RastoH/eXtended-Coop-Controller/webUI/readme.md

# 1. Main page
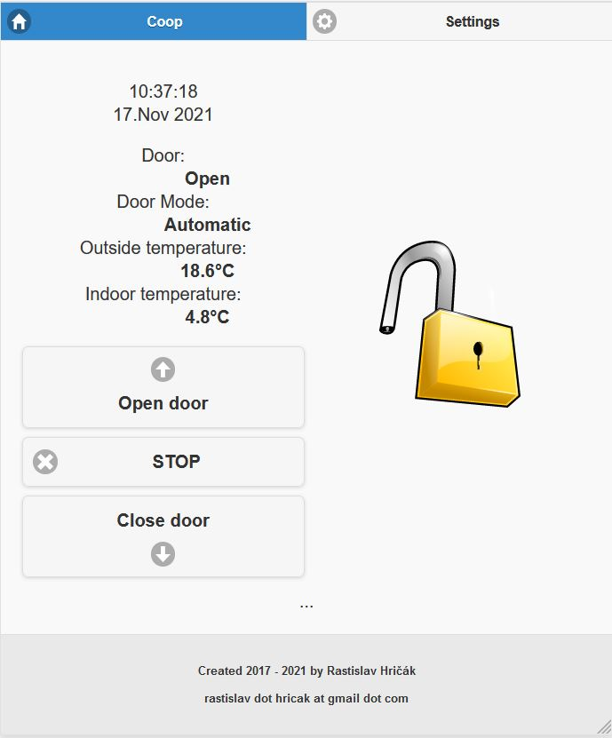
[picture p3: webUI/main1.JPG]

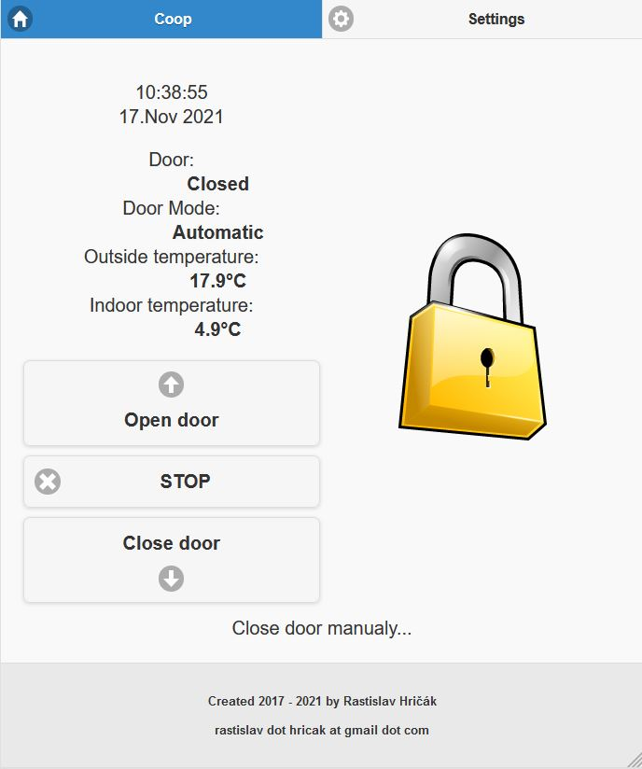
[picture p4: webUI/main2.JPG]

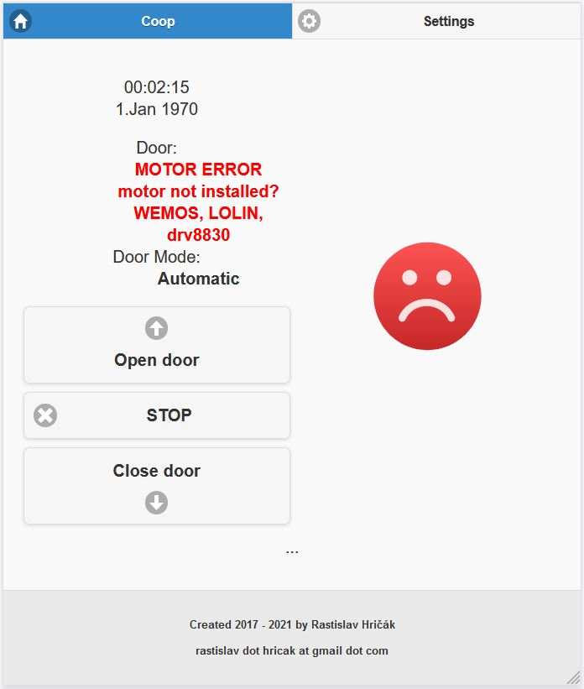
[picture p5: webUI/main_without.JPG]


# 2. Settings page
## 2.1 Door settings

#### 2.1.1 Door modes 

#### 2.1.1.1 Manual

#### 2.1.1.2 Light 

#### 2.1.1.3 Time

#### 2.1.1.4 Automatic mode
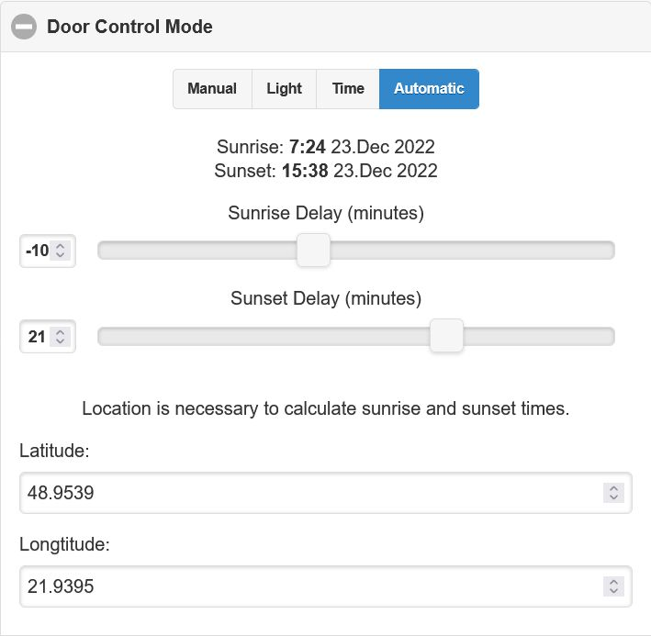
[picture p6: webUI/door_mode_automatic.jpg]

The location of interest, in decimal degrees.    

***Latitude*** is a coordinate that specifies the north–south position of a point on the surface of the Earth or another celestial body.
> Latitude ranges	from -90 (south pole) to 90 (north pole).

***Longitude*** is a geographic coordinate that specifies the east–west position of a point on the surface of the Earth, or another celestial body.
 > Longitude ranges	from -180 (west of Greenwich) to 180 (east of Greenwich).
  
### 2.1.2 Freeze protect

### 2.1.3 Quarantine

## 2.2 Accessory settings
#### 2.2.1.1 Hen light 
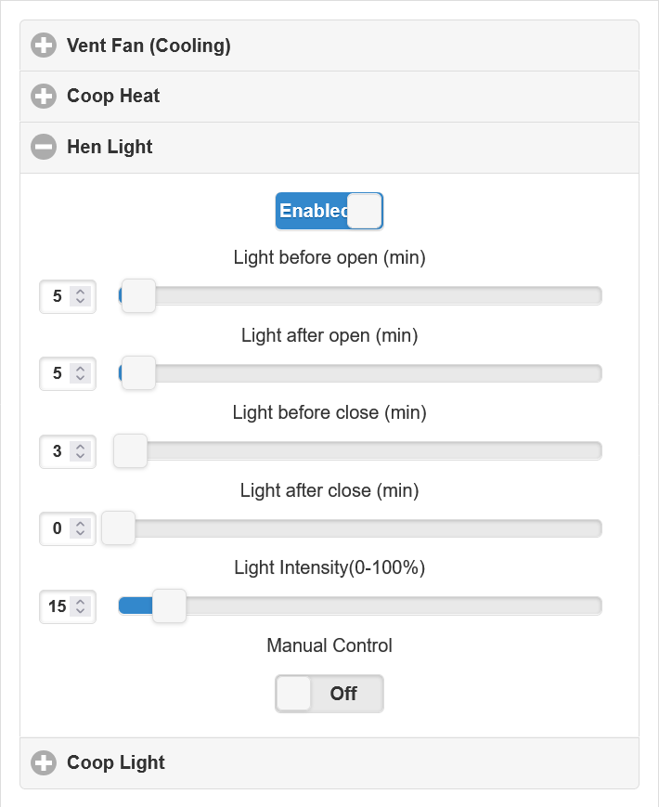
[picture p7: webUI/hen_light.png]

#### 2.2.1.2 Coop light 
#### 2.2.1.3 Vent Fan (Cooling)
#### 2.2.1.4 Heater
### 2.2.2 Water heater 
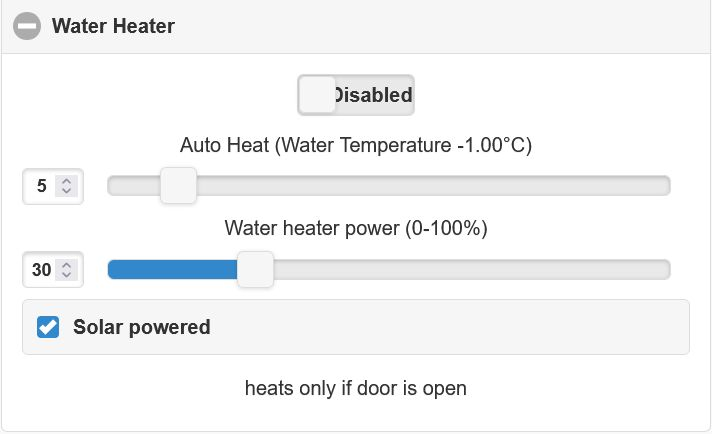
[picture p8: webUI/water_heater.jpg]

## 2.3 System config

### 2.3.1 Door name
### 2.3.2 Security
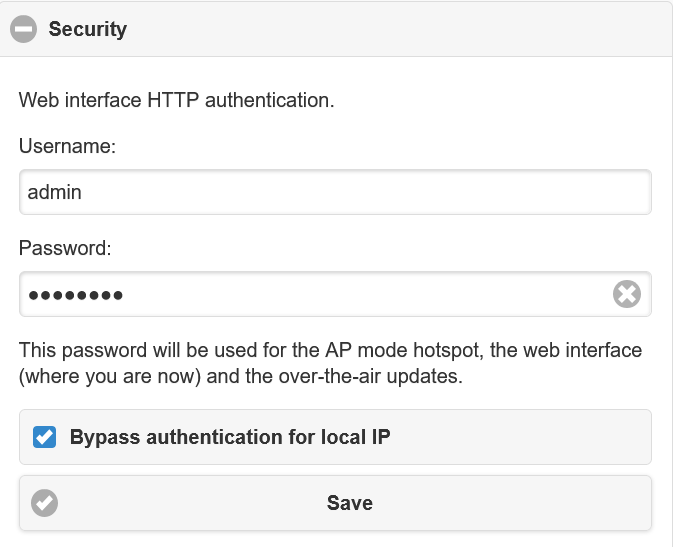
[picture p9: webUI/security.png]

### 2.3.3 Date-Time
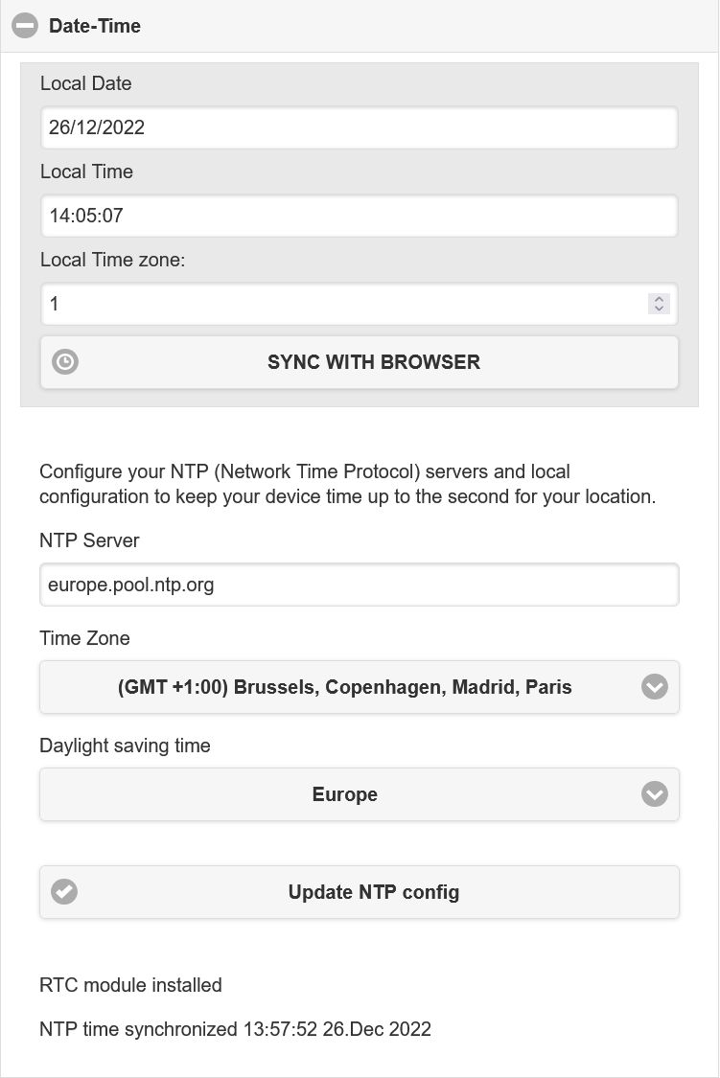
[picture p10: webUI/date-time.jpg]

### 2.3.4 WiFi network
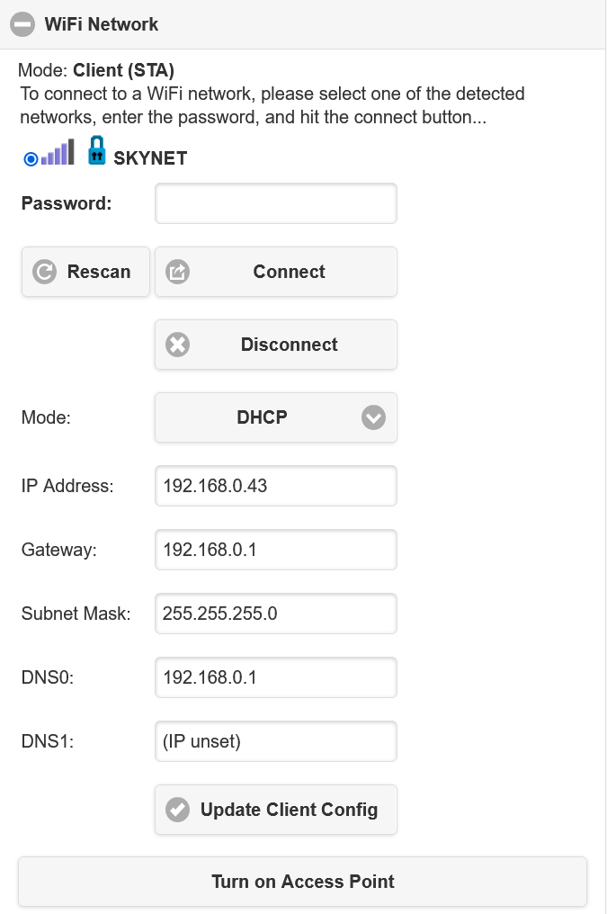
[picture p11: webUI/wifi_sta_client.png]

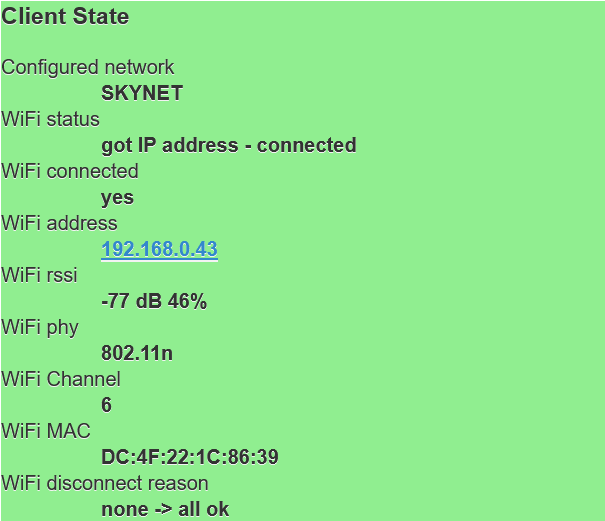
[picture p12: webUI/wifi_Client_State.png]

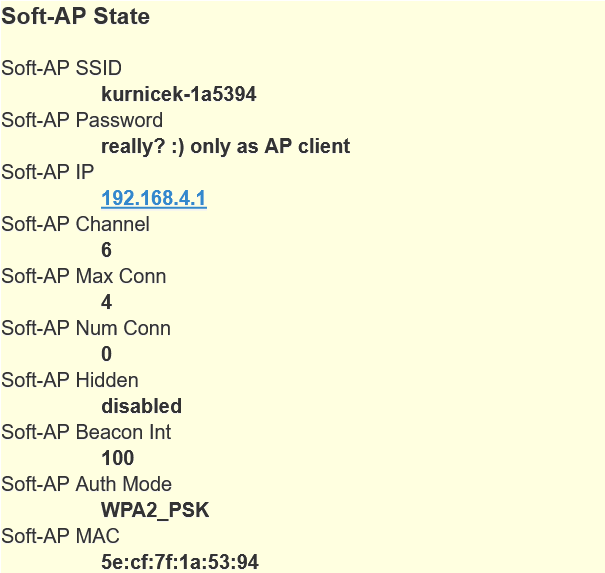
[picture p13: webUI/wifi_Soft-AP_State.png]

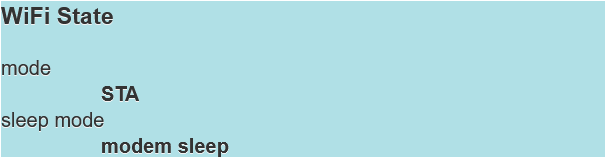
[picture p14: webUI/wifi_WiFi_State.png]

### 2.3.5 ThingSpeak
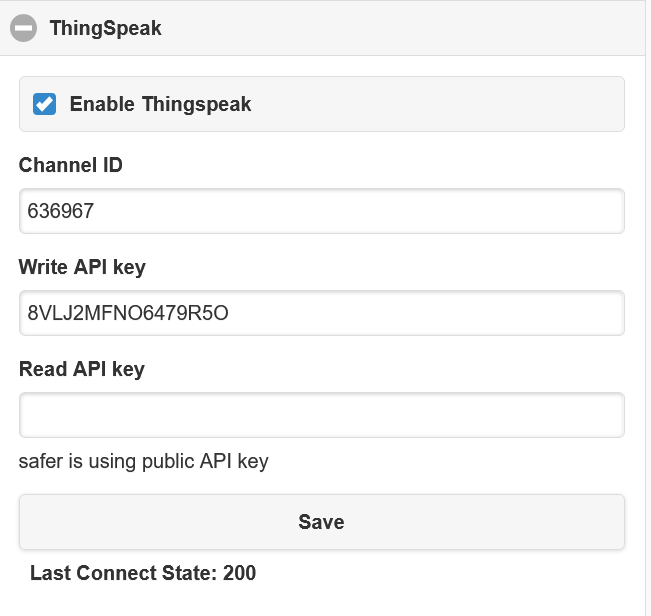
[picture p15: webUI/thingspeak.png]


## 2.4 System info
### 2.4.1 Thermometers
#### assigning the thermometer to the measured location
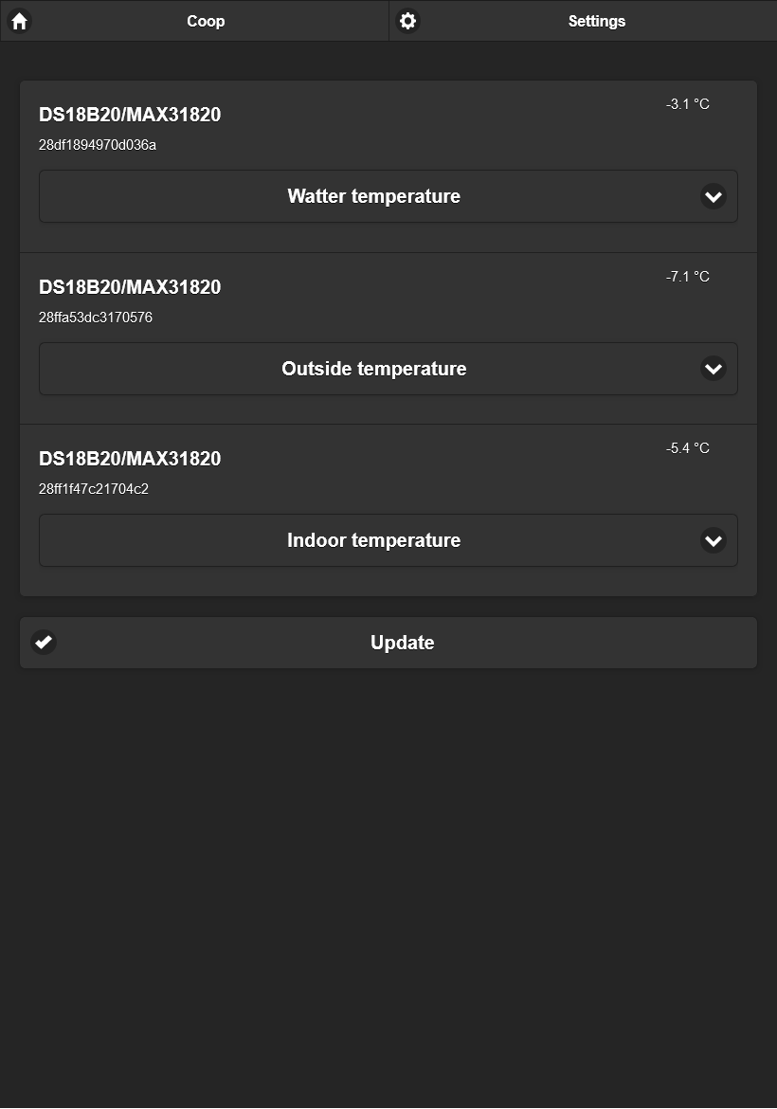
[picture p16: webUI/Thermomoters.png]


REST API GET -> http://192.168.0.43/temp?sensor1=2&sensor2=3&sensor3=1

Mainly needed when gradually adding sensors.
Dallas temperature sensors DS18B20 are always detected at start-up according to the serial number in ascending order.

# 4. Update (web OTA)
**/update**

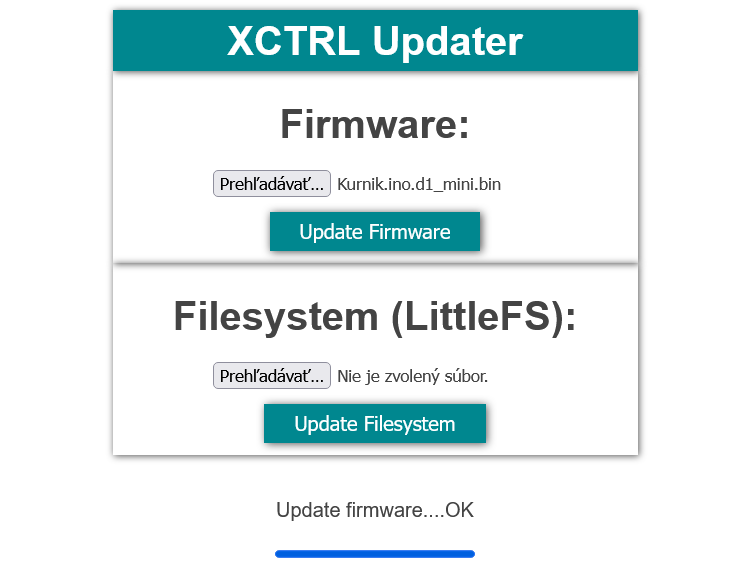
[picture p17: webUI/updater.png]

# 5. REST API

/state
GET
  state info

/settings
GET
  door settings

/config
GET
  controller config

/wifi
/rescan
GET
  wifi info

/thngspk
GET
  ThingSpeak config, info

/info
GET
  xctrl info

/update
  OTA, update firmware, filesystem page

/reset
  reset to factory dwfault

/restart
  restart system

/log
/logold
GET
  loger file for debug

/crash
GET
  crash info
