RastoH/eXtended-Coop-Controller/firmware/ESP8266-DOWNLOAD-TOOL.png

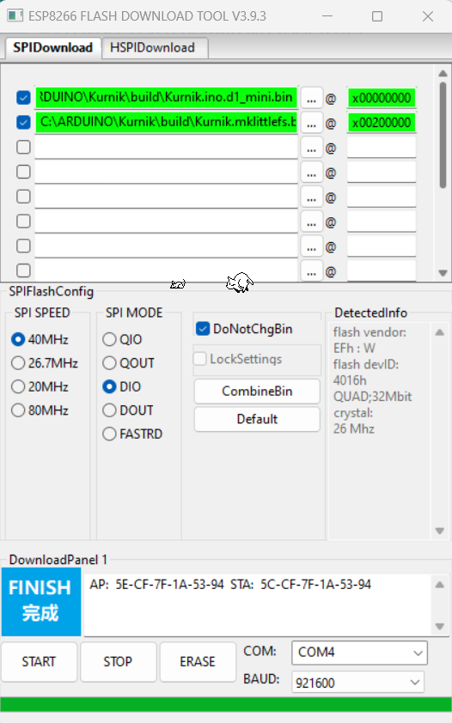
firmware/ESP8266-DOWNLOAD-TOOL.png
