RastoH/eXtended-Coop-Controller/firmware/XCTRL-Updater.png

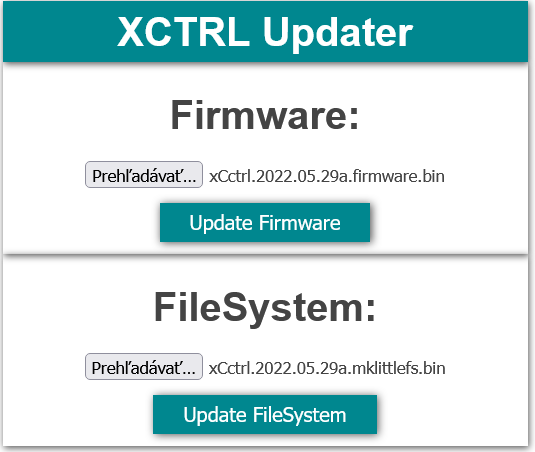
firmware/XCTRL-Updater.png
