RastoH/eXtended-Coop-Controller/hardware/Lolin4at8870.jpg

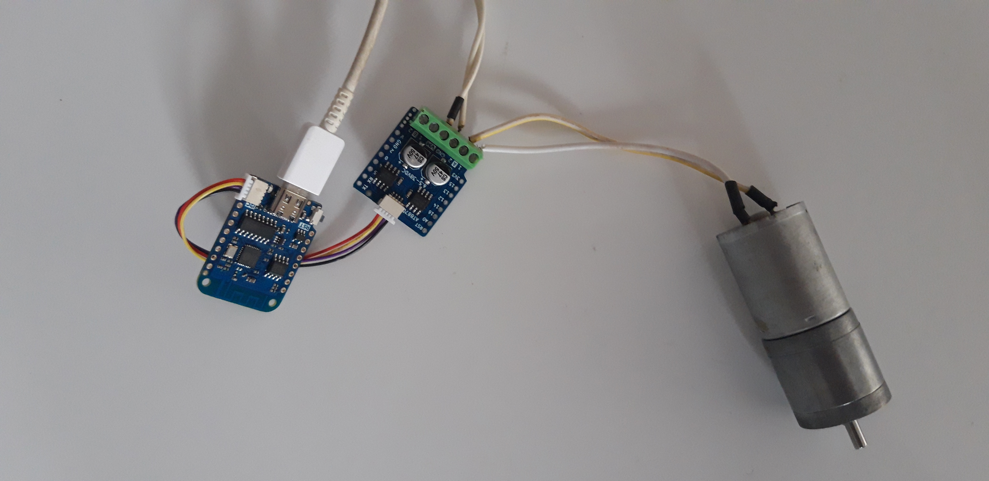
hardware/Lolin4at8870.jpg
