RastoH/eXtended-Coop-Controller/webUI/DarkModeHenLight.png

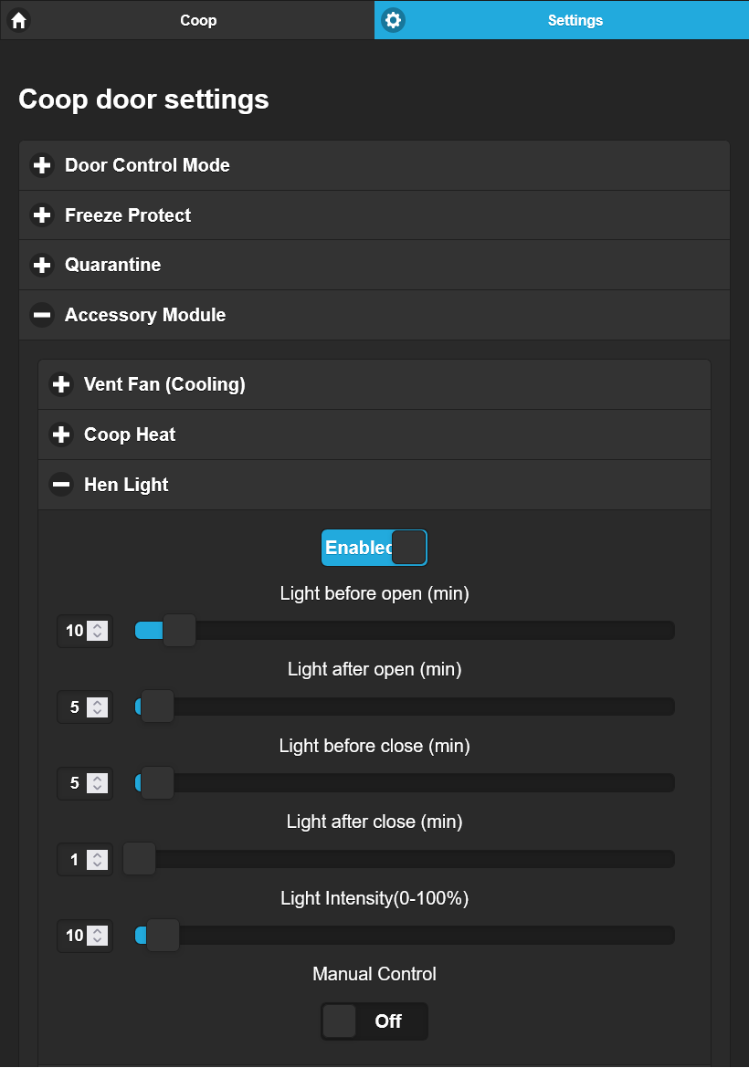
webUI/DarkModeHenLight.png
