RastoH/eXtended-Coop-Controller/webUI/DarkModeInfo.png

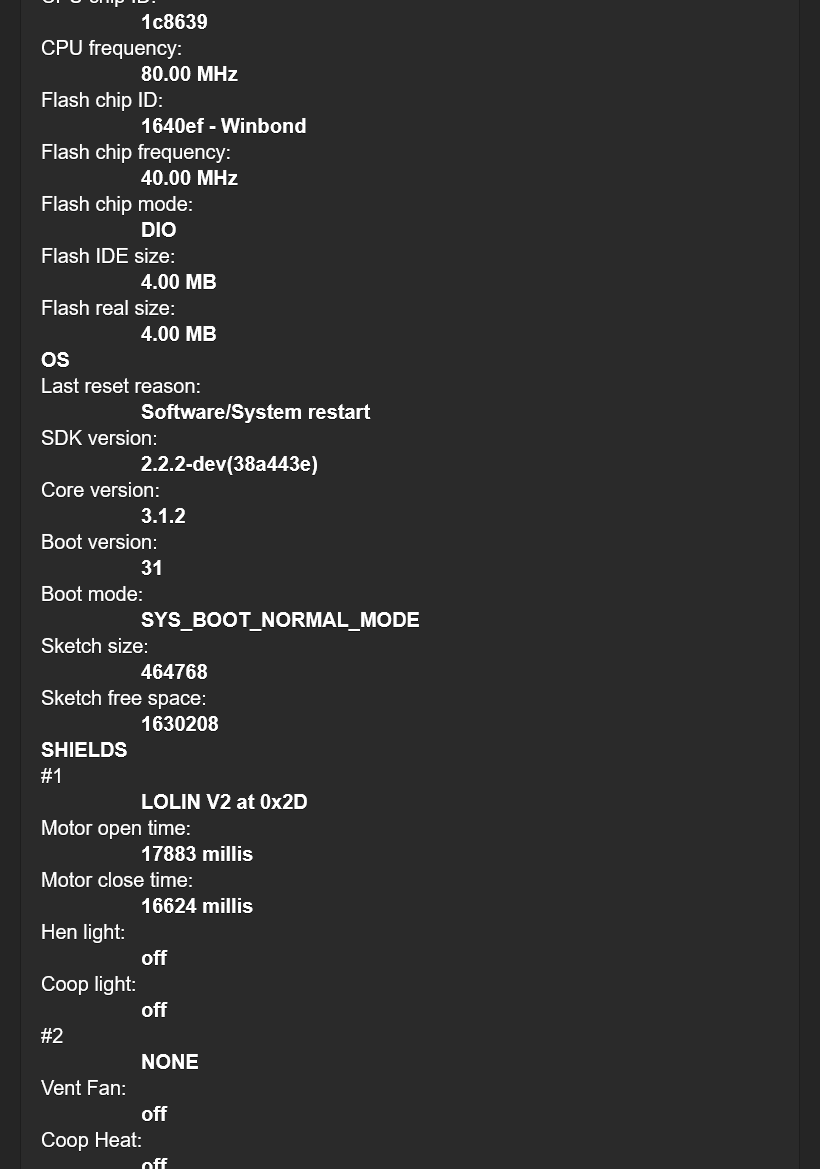
webUI/DarkModeInfo.png
