RastoH/eXtended-Coop-Controller/webUI/DarkModeMain.png

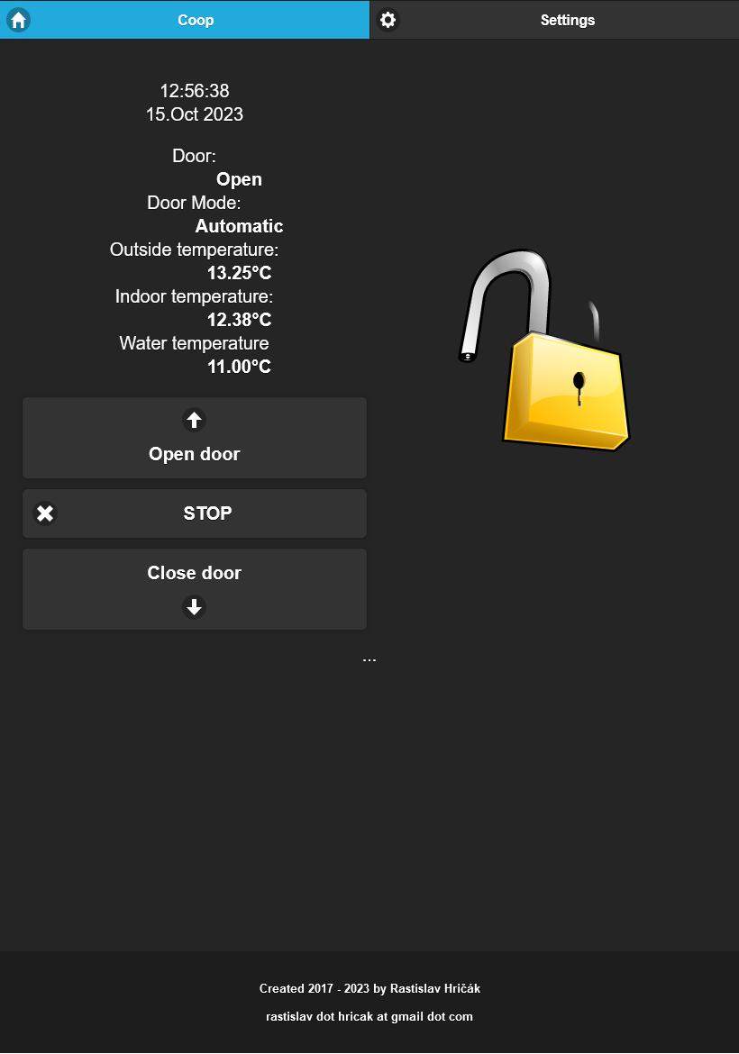
webUI/DarkModeMain.png
