RastoH/eXtended-Coop-Controller/webUI/DarkModeSettings.png

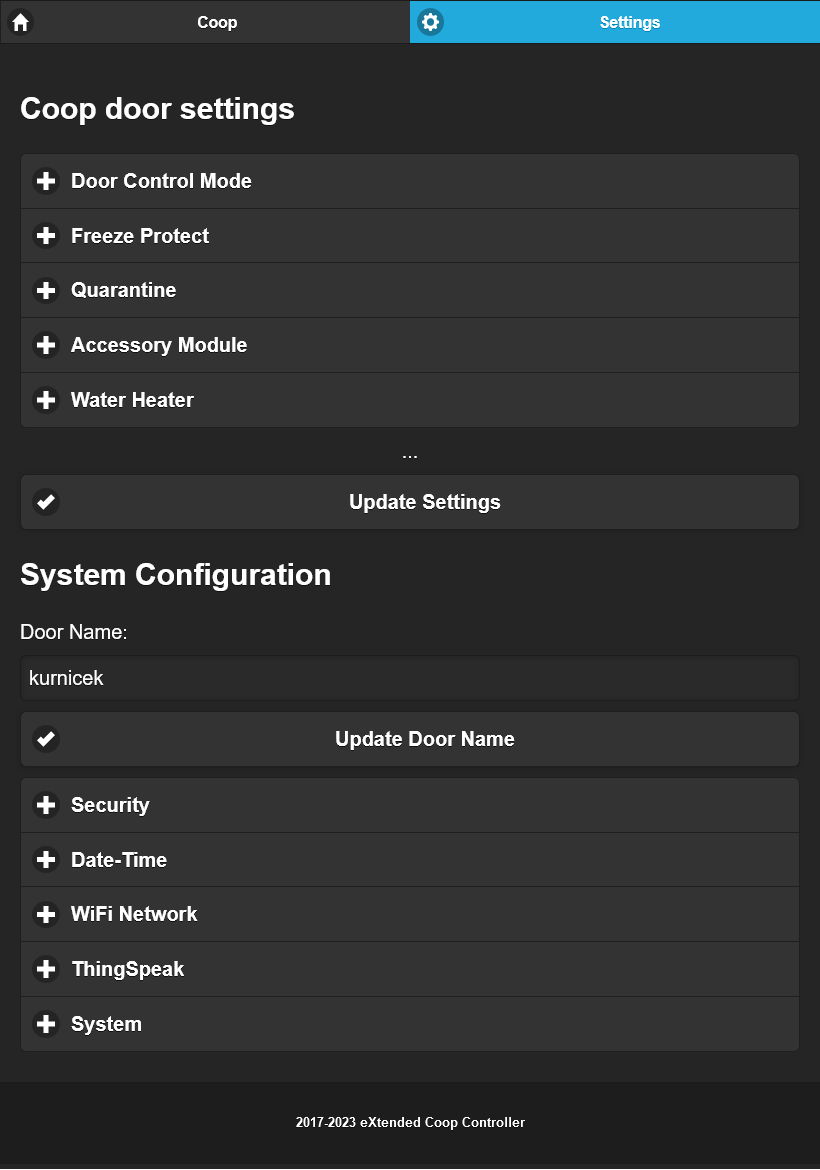
webUI/DarkModeSettings.png
