RastoH/eXtended-Coop-Controller/webUI/I2C_overview.png

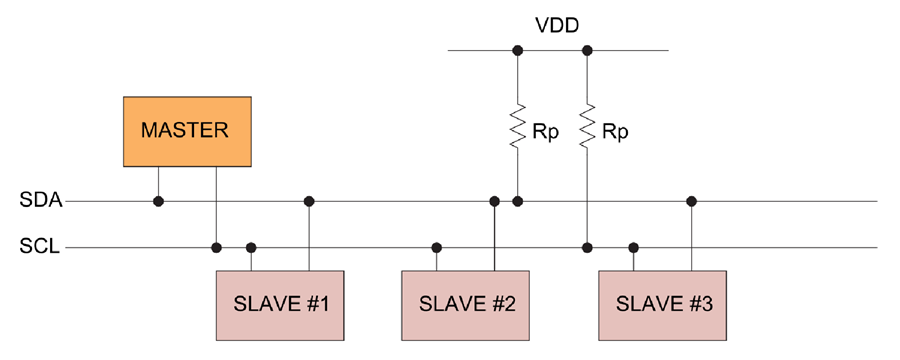
webUI/I2C_overview.png
