RastoH/eXtended-Coop-Controller/webUI/OneWire.jpg

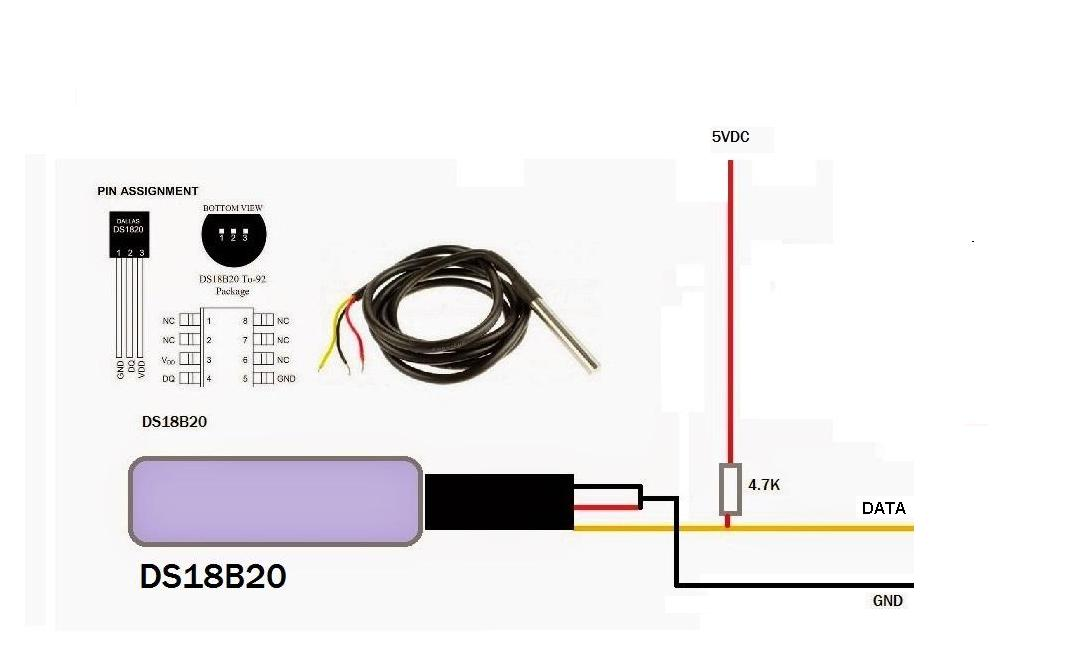
webUI/OneWire.jpg
