RastoH/eXtended-Coop-Controller/webUI/reed_switch.png

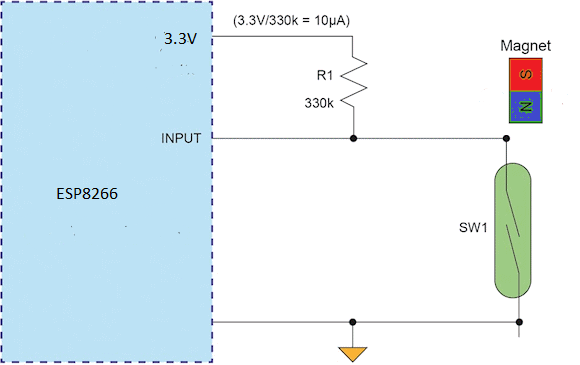
webUI/reed_switch.png
