RastoH/eXtended-Coop-Controller/webUI/settings1.JPG

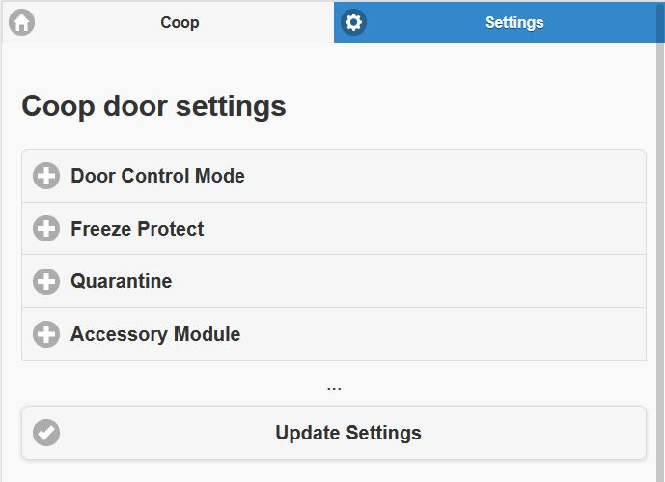
webUI/settings1.JPG
