RastoH/eXtended-Coop-Controller/webUI/settings2.JPG

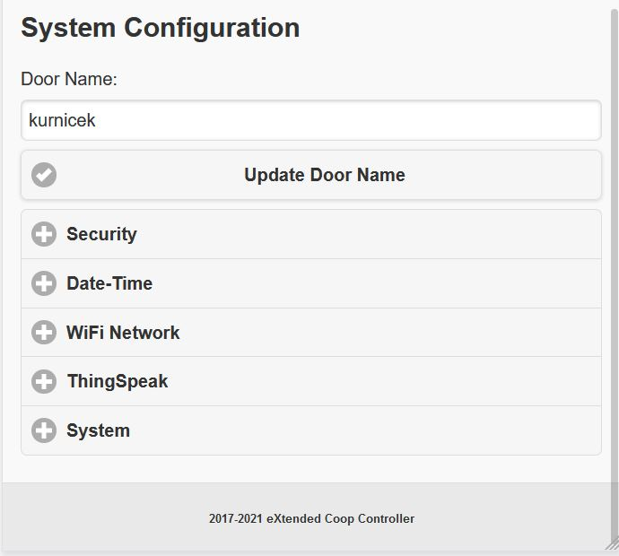
webUI/settings2.JPG
