RastoH/eXtended-Coop-Controller/(threads)

Thread 3 (2022-10-27):

WEB INTERFACE NOT FOUND

helidave, 2022-10-27:
Hi, I thought I would try your project to look after my small flock of silkies  but I wanted to use an Adafruit Huzzah32 that I had gathering dust.  I have been able to load the binaries but cannot access the web page at 192.168.4.1.  I note the following differences between my installation and the posted version.
1) The zip file gives me xCctrl.2022.05.29a.all.bin not xCctrl.2022.05.29a.bin
2) The initial wifi zone is kurnicek-c32c99 which is also different than the one shown in the post

I have loaded the examples wifinetwork code into the Huzzah just to check if the browser link works and can confirm it does so I assume I am making a mistake when loading the bin files.  Any help would be most welcome and hello from France!
Regards
David

RastoH, 2022-11-12:
xCCtrl is writen, compiled, tested only for **ESP8266**, Adafruit Huzah32 has core **ESP32**, _diferent_.

1. xCctrl.2022.05.29a.all.bin is firmware + filesystem
xCctrl.2022.05.29a.bin if only firmware
2.  kurnicek-xxxxxx  -> xxxxxx is device serial number
kurnicek is only preprogrammed name, can be changed via web interface

helidave, 2022-11-19:
thanks for the response, I thought I was doing something stupid! Ive ordered the right modules and will try again when they arrive I will hopefully have more success

helidave, 2022-12-01:
I picked up the correct esp 8266 module and loaded the xCctrl.2022.05.29a.all bin etc. as shown.  However I have the same issue, I cannot ping the 192.168.4.1 address and when I check the settings of the module I can see its connected but has no IP address - The first time the module boots I a asked for the password and enter fery1234 which gets it to connect. - Any ideas what I am doing wrong?

RastoH, 2022-12-01:
Five me output from 192.168.4.1/info

helidave, 2022-12-01:
its a WeMos D1 mini Pro. With the binary files I can connect but it doesn't get an IP address so I cannot access it at all.  If I load the wifi access point example from the Arduino library then I can connect without issues and ping the  module and get the "connected " page up

RastoH, 2022-12-02:
Test xCctrl.2022.05.31d. it's dev version, but in my coop works, tested on my LOLIN D1 Mini V3.1.0 4MB and ESP8266 Witty Cloud ESP-12F WiFi Module. See firmware/ESP8266-DOWNLOAD-TOOL.png

helidave, 2022-12-04:
Apologies for late response, my neighbour was very ill over the weekend and I had to prioritise him.  The new binaries work perfectly - thank you very much for all the effort helping me.  I will be busy building the rest of the system over the next week and hopefully upgrade my chicken coop before Christmas - really excited to install this system, it looks fantastic.

Closed 2022-12-13.

Thread 4 (2022-11-17):

Pinouts

SThM-develop, 2022-11-17:
Hi,
firstly congrats to great job.

I want to try this project on my coop. For sure pin numbers that you use at [pin section](https://github.com/RastoH/eXtended-Coop-Controller#pin) are from older [LOLIN D1 mini v 3.1.0](https://www.wemos.cc/en/latest/d1/d1_mini_3.1.0.html), right? Is possible to use latest version [LOLIN D1 mini v 4.0.0](https://www.wemos.cc/en/latest/d1/d1_mini.html) which one are you referring to in the main [README.md](https://github.com/RastoH/eXtended-Coop-Controller#readme)? Will be there some pin changes?

And I would also like to ask where the coop fan/heater and the LED light are connected? I couldn't find that anywhere.

Really thanks for answer.
Thomas

RastoH, 2022-11-17:
Motor, LEDs are conected on motor driver -> [LOLIN v2 (tested)](https://www.wemos.cc/en/latest/d1_mini_shield/motor.html), [AT8870 Motor Shield](https://www.wemos.cc/en/latest/d1_mini_shield/at8870_motor.html), [HR8833 Motor Shield](https://www.wemos.cc/en/latest/d1_mini_shield/hr8833_motor.html)

Channel A -> door motor
CHannel B -> hen light

FAN/HEATER is in dev mode, not fully working, it uses second motor driver on i2c, i rewrite libraries to MCP230xx or PCF8574.

Closed 2022-12-18.

Thread 6 (2022-12-13):

Lolin AT8870 Motor Shield

helidave, 2022-12-13:
I am using the above shield (it was the only one I could find!) and it works correctly when I test it on the bench using an Arduino Nano and the lolin test software.  When I try it (piggy backed) onto the main board I get no output.  I have tried both Port A and Port B.  I believe the software communicates with the board over I2C as if I remove the board I get the expected error.  I do notice that under "system" it comes up as LOLIN V2 board whereas in reality it is the v1.0 AT8870 board.  The motor board is fed from my bench PSU and the WEMOS is fed from a 2A USB.  I also tried using the coop light  commands to see if that forced an output on either port but also without success. Thanks in  advance.

helidave, 2022-12-13:
I should mention, I checked the board address and it is 0x30 but I guessed that, as the board was being "seen" the dress was correct anyway. I also tried moving the AT8870 board to a separate place on the breadboard and just connecting the 3.3v/GND/SCL/SDA/5V Lines in case there was a conflict.

helidave, 2022-12-16:
I have checked the board connections again and they all seem correct so I am guessing the address (0X30) indicated is correct for the board but not correct for the software.  Looking at the YouTube video I see that its shows an address of 0X2D for the V2 board. I see in the Arduino examples page for the LOLIN board the address can be changed so I will see if that sorts it.  I checked on the internet and couldn't find details of the default V2 address.

helidave, 2022-12-17:
Okay...so much for that theory - I'm clearly doing something stupid because the software recognises the board with both the default address and the OX2D address.  I wondered if the other channel controlling the coop light had an o/p so I put the motor one this and ran it from the light control command - success, the motor moves!  So the motor shield is connected correctly, is recognised by the software and at least one channel is under control.  The motor must be inhibited somewhere else.  I will put a LED strip on the second channel to just confirm all is well and then back to the motor issue.

RastoH, 2022-12-17:
Chanel A is used for door motor
1 - motor - 2

Chanel B is for LEDs
1 - LED STRIP - minus
2 - LEDSTRIP - minus

helidave, 2022-12-17:
Im using a Lab PSU to test the unit on the bench and it all seems to work as expected except I cannot get an output on 1-A-B on the AT8870 V4 board.  My motor is the GA25 6V 35rpm version (its what I was using on the coop before) and it works fine with the LOLIN motor test software.  In fact, if I connect it to 1-B-2 instead of a LED it runs when I send the door open or close command (of course only in one direction).  I do notice that, even though the Lights are not enabled in the settings tab, when I send a door open or close command the LED on 1-B-2 illuminates for a few seconds.

RastoH, 2022-12-17:
update firmware to xCctrl.2022.05.31m.
it works flawlessly in my coop (with LOLIN V2 [TB6612FNG]).

I have new 8870 boards, I will test them tomorrow.

RastoH, 2022-12-18:
Tested, works.

Tested with 9Volts, using SGM25F-370 12Volt geared motor.

Dont tested on 6Volts, AT8870 is for 6.5Volts-38Volts

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

helidave, 2022-12-18:
Hi, I know the AT8870 specifies a minimum voltage of 6.5 v so I feed it 8v from the lab PSU, the small dc 6V motor is fine with it on the test program and I have run these small motors before with up to 9v without issues so hope I can get away with it again, if not I will order the 12v version after Christmas.  After the match today I am going to try the new code as you suggest.  Many thanks.  David

RastoH, 2022-12-18:
my test
http://192.168.4.1/log

[SETUP 414] ---=== Reset reason: External System ===---
[SETUP 733]  BootVersion : 31  BootMode : SYS_BOOT_NORMAL_MODE  CPU freq : 80
[SETUP 1056] --=== FIRMWARE: xCctrl.2022.05.31r-dev [build 221218] ===--
[SETUP 1384] > SIZE OF settings: 408,  stav: 200,  RTC: 8
[ERROR 1722] config file - Failed to open config.
[SETUP 2059]  [i2c] Scanning ...
[SETUP 2404]  [i2c] device found at address 0x2D
[SETUP 2795]  0x2D => 0x30     Motor shield WEMOS V1.0.0 or LOLIN V2.0.0
[SETUP 3141]     Motor shield LOLIN LOLIN V2 AT8870 motor driver Rev. 4 at 0x2D found
[SETUP 3505] [i2c] scan done (1)===---
[SETUP 3860] RTC not installed.....
[SETUP 4220] ---=== LightSensor ===---
[SETUP 4579] Using LDR on A0
[SETUP 4943] Ambient light intensity: 2 %
[SETUP 5307] ---==== Door switches + motor ===---
[SETUP 5675] Door is ajar
[SETUP 6043] Motor shield LOLIN V2 AT8870 at 0x2D
[SETUP 6569] Accessory shield NONE
[SETUP 7098] ---=== DallasTemperature ===---
[SETUP 7476] Found 0 devices.
[WiFi 7857] --== WiFi SETUP ==--
[INFO 8250] Configure TCP (HTTP)webServer->...
[INFO 8638] HTTP server start....
[SETUP 9028] HTTP server started.
[SETUP 9419] --==  SYSTEM START ==--
[WiFi 9814] --== WiFi INIT ==--
[WiFi 10209] --== AP -> ON ==--
[WiFi 11014] mode change OFF -> AP
[WiFi 12301] SoftAP: kurnicek-b597db start
[WiFi 12809] --== STA -> ON ==--
[WiFi 13222] mode change AP -> STA+AP
[WiFi 13731] WiFi STA: conect to SKYNET start
[WiFi 17512]   Station Connected to SKYNET, channel 1
[INFO 2022-12-18T16:12:43M19701] sntp => RTC update  Mon Dec 18 16:12:43 2022
[INFO 2022-12-18T16:12:44M20133] ---=== [calculate TimeLord] ===---
[INFO 2022-12-18T16:12:44M20570] Sunrise (open) Time: 07:21 18/12/2022
[INFO 2022-12-18T16:12:45M21010] Sunset (close) Time: 15:36 18/12/2022
[INFO 2022-12-18T16:12:45M21455]  Dlzka dna: 495 min     08:15
[INFO 2022-12-18T16:12:45M21905] ------======[END]======------
[WEB 2022-12-18T16:13:37M73174] ---=== handleState POST ===---
[WEB 2022-12-18T16:13:37M73622] Close door manualy...
[INFO 2022-12-18T16:13:38M74078] [MANUAL] door close
[WEB 2022-12-18T16:13:45M81618] ---=== handleState POST ===---
[INFO 2022-12-18T16:13:46M82077] Stop door - manualy - will be put into manual mode.
[WEB 2022-12-18T16:13:46M82543] Door will be put into manual mode. <br> RESET to re-enable automatic door control.<br>
[WEB 2022-12-18T16:13:52M88631] ---=== handleState POST ===---
[WEB 2022-12-18T16:13:53M89110] Open door manualy...
[INFO 2022-12-18T16:13:53M89597] [MANUAL] door open
[WEB 2022-12-18T16:14:02M98037] ---=== handleState POST ===---
[INFO 2022-12-18T16:14:02M98527] Stop door - manualy
[WEB 2022-12-18T16:14:03M99023] Door stop.
[WEB 2022-12-18T16:14:20M116828] ---=== handleState POST ===---
[WEB 2022-12-18T16:14:21M117330] <br>Coop light intesity 5%<br>Hen light ON, <br>Hen light intesity 5%
[INFO 2022-12-18T16:14:21M117846] Hen Light ON -> 5
[WEB 2022-12-18T16:14:25M121824] ---=== handleState POST ===---
[WEB 2022-12-18T16:14:26M122394] <br>Hen light intesity 40%
[WEB 2022-12-18T16:14:29M125719] ---=== handleState POST ===---
[WEB 2022-12-18T16:14:30M126248] <br>Hen light OFF,
[INFO 2022-12-18T16:14:30M126781] Light OFF
[WEB 2022-12-18T16:14:35M131444] ---=== handleState POST ===---
[WEB 2022-12-18T16:14:36M131982] <br>Coop light intesity 45%
[WEB 2022-12-18T16:14:38M133978] ---=== handleState POST ===---
[WEB 2022-12-18T16:14:38M134525] <br>Coop light ON
[INFO 2022-12-18T16:14:39M135085] Coop Light ON -> 45
[WEB 2022-12-18T16:14:42M138241] ---=== handleState POST ===---
[WEB 2022-12-18T16:14:42M138801] <br>Coop light OFF
[INFO 2022-12-18T16:14:43M139369] Light OFF

helidave, 2022-12-18:
Hi, My AT board is from ALIEXPRESS  but it seems to work ok with the test programs LOLIN provide.  I just tried to load the new firmware into the D1 board but I get an "error loading page" message.  I swapped computer (normally I use a Mac) to a win 10 ASUS I have just in case but I get the same message.  If I try to load direct using the ESP Dwnloader it fails after a few minutes with a "try a slower baud rate" message but the min board rate is 115200 so I am unable to do that.  I also tried a couple of alternative usb cables as I have notice these can be quite different depending on supplier but again, same results.  I will have look at the log output as soon as the match finishes.

RastoH, 2022-12-18:
now tested on lolin d1 mini 4.0.0 (problem with spi flash, litflefs overide), witty cloud, node-mcu v3, all 4MB flash, all works corect.

flashed with  flash download tool 3.9.3 on win11

helidave, 2022-12-19:
Morning, Thanks for looking at this for me, much appreciated!!  Tested this morning on a Lolin MINI 4.0 and I now have motor control - fantastic.  At the moment the system is on a breadboard but I will try the LED lights later today and if they work I will transfer it to a proper enclosure for the coop.  The Temperature sensors work well.  I have a small problem with the RTC time settings, they are working but the sunrise and sunset times seem to be out by a couple of hours.  I have set the Long/Lat to my coordinates.  I will spend a little time checking my settings later today.  I loaded the binaries using Win 10.  I think this is the best coop control/monitor I have seen on the net, thank you for making it public.  I will add a photo when I get it all installed.

RastoH, 2022-12-20:
not tested with other lon/lat and time zone. I can try your parameters

helidave, 2022-12-21:
My location is set as  46.5633 - 3.3306.  Sunrise and sunset should be 08:28 & 17:01 but are shown as 03:54 & 15:49.  They don't seem to change no matter what location I give.  I synced the server etc.

helidave, 2022-12-21:
Just checked and if I set 46.5633N/3.3306E then times change to 06:54 & 19:01.  The system clock is spot on .

RastoH, 2022-12-21:
Longtitude: 3.3306
Latitude: 46.5633

change it!

Latitude is a coordinate that specifies the north–south position of a point on the surface of the Earth or another celestial body
Longitude is a geographic coordinate that specifies the east–west position of a point on the surface of the Earth, or another celestial body

helidave, 2022-12-23:
Oops - I blame it on my Covid vaccination!

Closed 2023-01-01.

Thread 7 (2023-01-06):

Motor RPM & Door timing

helidave, 2023-01-06:
Hi,  My coop is working well now thank you.
I just use a single motor board for the moment and have the specified 35rpm motor however, my previous system used a 12rpm motor and I quite like this as it is a little more "forgiving" on the slower chickens.  My question is: When I made a test with the slower motor the system failed because it timed out on the raise/lower timing.  Can this be extended to allow for the slower motor?

RastoH, 2023-01-07:
upload new version xCctrl.2023.05.32o
MOTOR_MAX_RUN_TIME 40 * MILLIS_IN_SEC (40 seconds)

firmware + littlefs!

helidave, 2023-01-07:
Okay, thanks I will try that tomorrow.  The system is working really well and the wifi Link is very solid - really pleased with it. I am very grateful you posted this, its great protection for my birds.

helidave, 2023-01-08:
I tried the above however,  it installed without issue but it wouldn't take the connection to my LAN.  I could connect via the AP but every time I tried to add my LAN wifi it would reboot  back to AP mode.  I installed xCctrl.2022.05.32k and reduced the stroke of my door to give the slower motor time to hit the limits.

RastoH, 2023-01-08:
xCctrl.2023.05.32oooo ?

helidave, 2023-01-08:
xCctrl.2023.05.32o but I travel to Ireland tomorrow for work and don't return until the weekend.  For this reason I put the old firmware back in and adjusted the door limits to compensate as I needed to leave my coop in working order.

helidave, 2023-01-15:
Im back from Ireland so will try the other binaries again this week to see if I can get it working with the 12rpm motor.  I was also wondering if its possible to drive a second motor but with just manual open/close commands. My coop has 2 sections, the main door is on the nighttime roosting area but I also have a second door which, when opened, allows the chickens to have free access to the garden area.  I wondered if it would also be possible to fit a motor to this door?

RastoH, 2023-01-17:
We don't have any free GPIOs for reed switches, it requires redesign of WebUI, sketches

helidave, 2023-01-17:
ah ah of course.  No worries, I will fit my old system on the external door and control it seperately - your system works flawlessly.  Its snowing here at the moment so I will have to wait for better weather to try the other binaries.

RastoH, 2023-01-26:
check xCctrl.2023.05.32rr-dev, it is my test version that is currently running in my chicken coop.

helidave, 2023-01-26:
Okay, will do.
I have to say your software is 100% the best I have used on my coop - it never loses connection, the time works flawlessly and its 100% reliable.

Closed 2023-02-26.
