RastoH/eXtended-Coop-Controller/(commit log)

2022-12-17 Add files via upload
    rewriten /update and i2c functions
2022-12-18 Add files via upload
    LOLIN D1 MINI 4.0.0
    LOLIN V2 motor shield AT8870
    9.0V 0.2A power suply
2022-12-18 Add files via upload
    Wire.setClock 100000Hz
2022-12-19 Add files via upload
    Daylight saving time, water heater (internal thermostat)
2022-12-20 Add files via upload
    water heater
2023-01-07 Add files via upload
    MOTOR_MAX_RUN_TIME 40 * MILLIS_IN_SEC
    update littlefs also, too many changes were made in RESTul API
2023-09-15 Add files via upload
    LittleFS 2.7.1
    ArduinoJson 6.21.3
2024-01-08 Add files via upload
    Allows you to assign the thermometer to the measured location, without the need to move sensors between measured locations
    my case:
    sensor 1 -> water,
    sensor 2 -> outside,
    sensor 3 -> inside
2024-01-23 Add files via upload
    TIME mode optimized,
    to-do WiFi power optimization
    Web interface modifi
    Config struct changed
